JulianSamblas/realtime-telemetry-esp32s3/docs/TFG_presentacion_Julian_Samblas.pdf

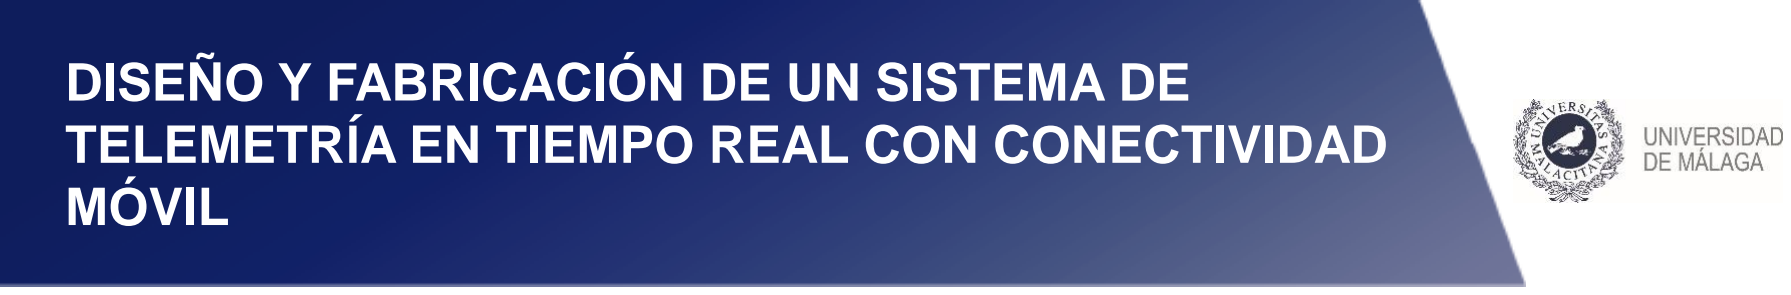
[picture p27: figure]
DISEÑO Y FABRICACIÓN DE UN SISTEMA DE; MÓVIL

### TELEMETRÍA EN TIEMPO REAL CON CONECTIVIDAD

Autor:
JULIÁN SAMBLÁS CABALLERO
Tutor:
JAVIER PÉREZ FERNÁNDEZ

GRADO EN INGENIERÍA ELECTRÓNICA INDUSTRIAL Trabajo Fin de Grado
Junio 2024

# ÍNDICE

DISEÑO Y FABRICACIÓN DE UN SISTEMA DE TELEMETRÍA EN TIEMPO REAL CON CONECTIVIDAD MÓVIL

## 1 Introducción

## 2 Telemetría y adquisición de datos

## 3 Componentes del dispositivo

## 5 Métodos de adquisición y visualización de datos

## 6 Montaje y pruebas realizadas al dispositivo en funcionamiento

## 7 Conclusiones y futuro del proyecto

## 4 Prototipos

# 1. INTRODUCCIÓN 1

4

2

5

3

6

Antecedentes:

- Pertenece al programa de maduración de proyectos UMA
- Tecnología del automovilismo de competición al usuario
amateur

Programa Synride

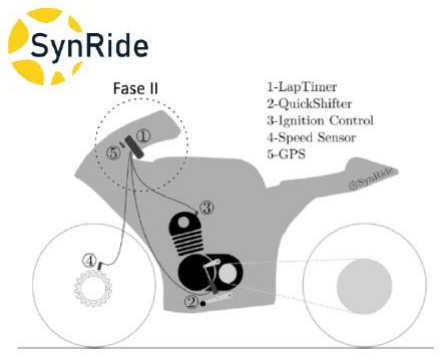
[picture p28: figure]

- Tiempo por vuelta
- QuickShifter
- Control de encendido
- Sensor de velocidad
- GPS

Modelo anterior

7

# 1. INTRODUCCIÓN 1

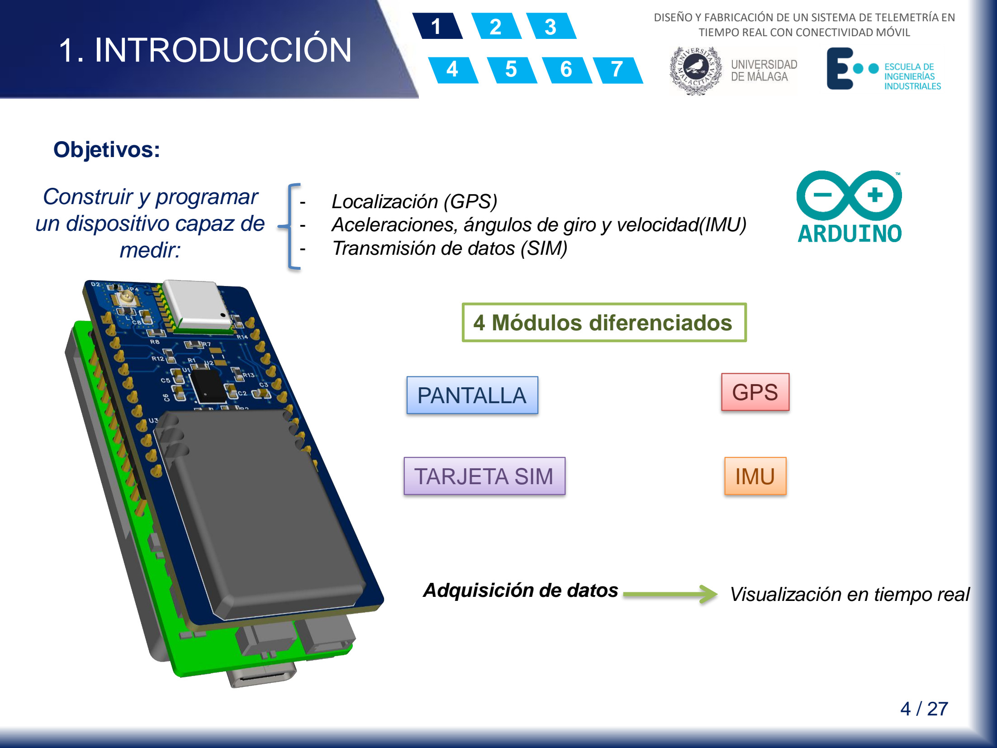
[picture p29: page 4]

4

5

6

Objetivos:

- Localización (GPS)
- Aceleraciones, ángulos de giro y velocidad(IMU)
- Transmisión de datos (SIM)

### 4 Módulos diferenciados

Adquisición de datos

Construir y programar
un dispositivo capaz de
medir:
PANTALLA | GPS
TARJETA SIM | IMU

Visualización en tiempo real

7

## 2. TELEMETRÍA Y ADQUISICIÓN DE DATOS

1

4

5

6

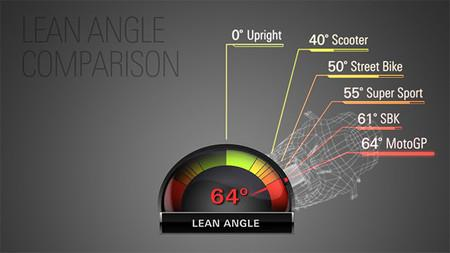
[picture p30: figure]

1) ¿Qué es la telemetría y adquisición de

datos?

2) Estado del arte
3) Importancia de la adquisición de datos en la

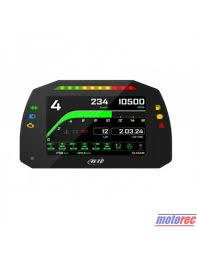
[picture p31: figure]

actualidad

4) Importancia de la adquisición de datos en el

mundo del motor

5) Telemetría aplicada a la competición
6) Objetivos del sistema proyectado

7

## 3. COMPONENTES DEL DISPOSITIVO

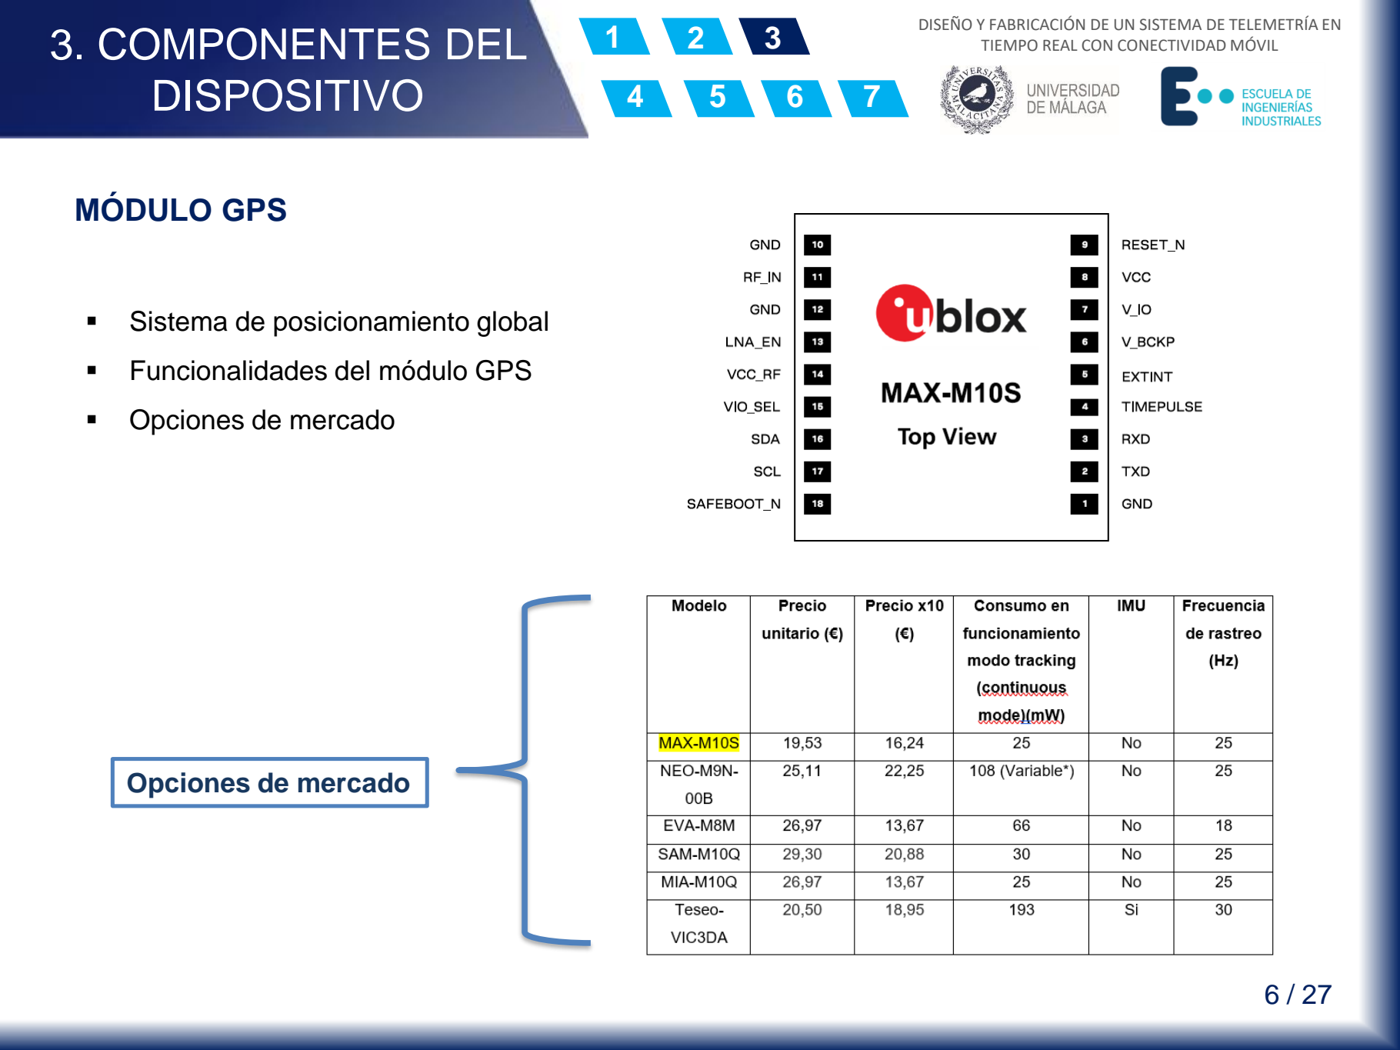
[picture p32: page 6]

4

5

6

- Sistema de posicionamiento global
- Funcionalidades del módulo GPS
- Opciones de mercado

MÓDULO GPS

Opciones de mercado

7

## 3. COMPONENTES DEL DISPOSITIVO

4

5

6

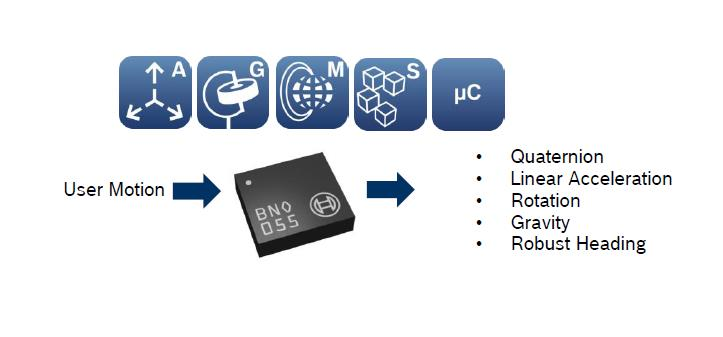
[picture p33: figure]

- Desempeña un papel crucial
- Medición de aceleración y velocidad angular
- Análisis de inclinación
- Sistemas de estabilización electrónica

UNIDAD DE MEDIDA INERCIAL (IMU)

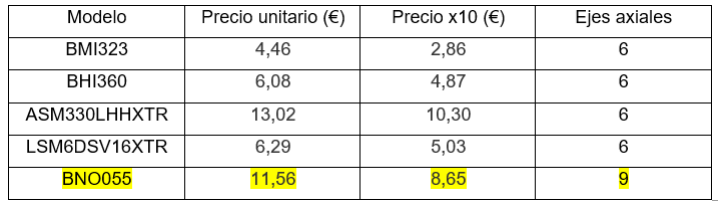
[picture p34: figure]

Opciones de mercado

7

## 3. COMPONENTES DEL DISPOSITIVO

4

5

6

- Enviar la información obtenida a través de internet
- Ocupación de espacio mínimo en la placa PBC
- Capacidad de operar en una banda 4G

MÓDULO SIM

Opciones de mercado

7

## 3. COMPONENTES DEL DISPOSITIVO

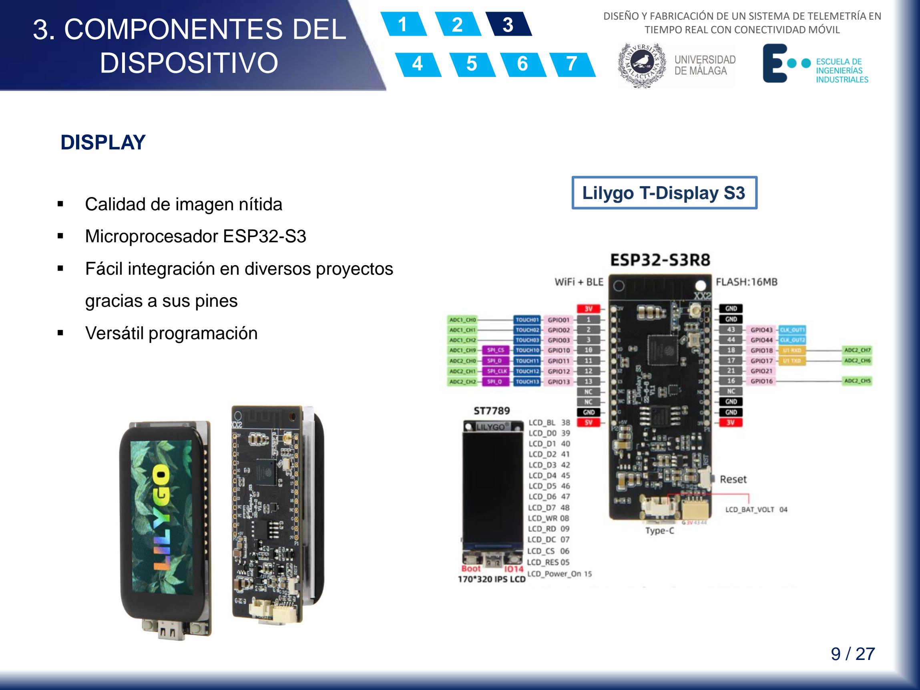
[picture p35: page 9]

4

5

6

- Calidad de imagen nítida
- Microprocesador ESP32-S3
- Fácil integración en diversos proyectos

gracias a sus pines

- Versátil programación

DISPLAY

Lilygo T-Display S3

7

## 4. PROTOTIPOS

4

5

6

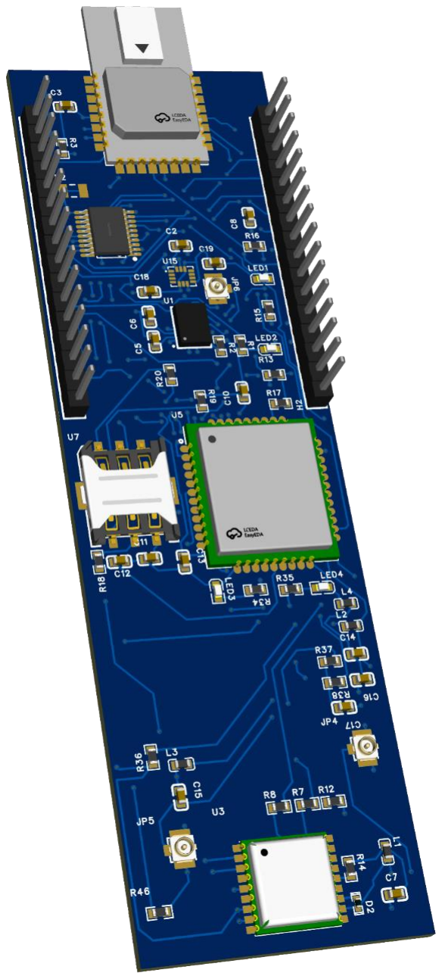
[picture p36: figure]

PRIMER PROTOTIPO

Basado en la placa T-SIM7080G-S3

- Potente procesador
- Incorporación del módulo SIM

Módulos acoplados

- Dos sistemas de posicionamiento: MAX-M10S y DWM3000
- Dos sistemas inerciales de medida: BNO055 y BMI323.

7

## 4. PROTOTIPOS

4

5

6

PRIMER PROTOTIPO

7

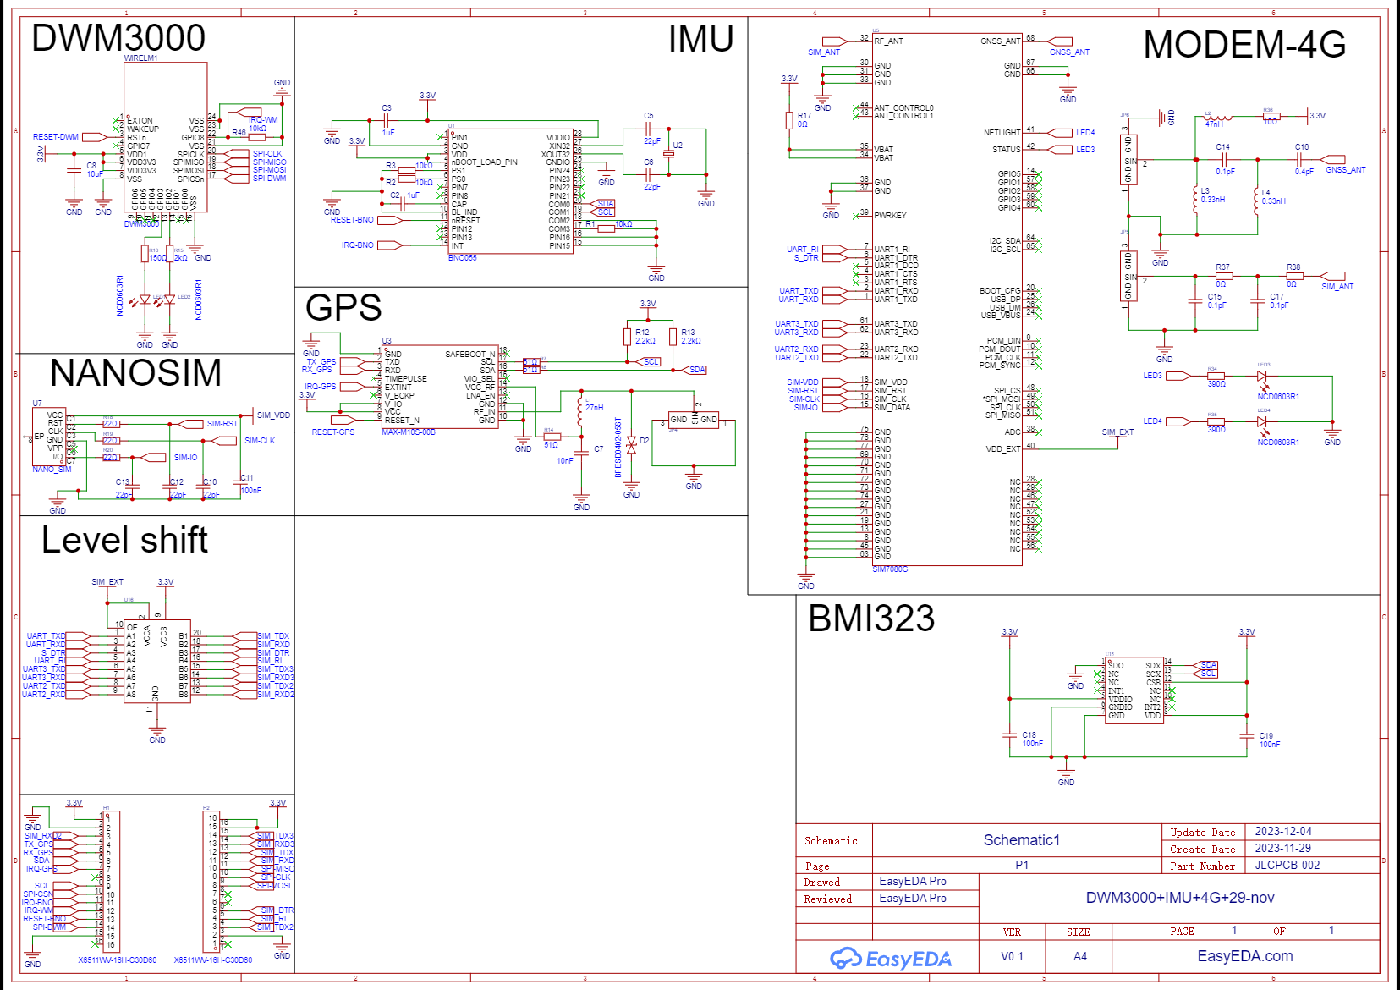
[picture p37: figure]

## 4. PROTOTIPOS

4

5

6

SEGUNDO PROTOTIPO

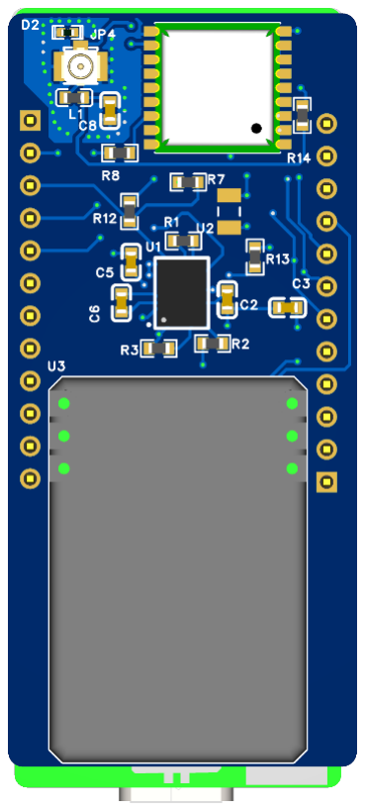
[picture p38: figure]
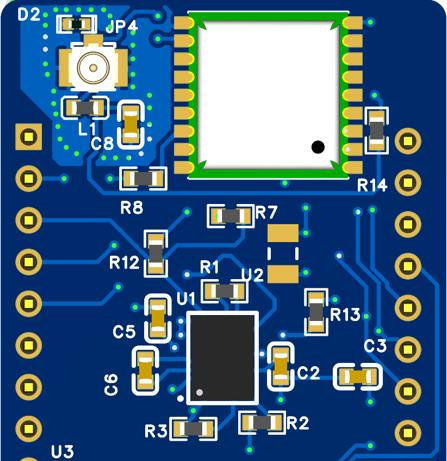
[picture p39: figure]

Basado en el dispositivo T-DISPLAY-S3

- Potente procesador
- Menor tamaño
- Acople de display

Módulos acoplados

- Sistema de posicionamiento:

MAX-M10S

- Sistema inercial de medida:

BNO055

- Módulo SIM: SIM7080

7

## 4. PROTOTIPOS

4

5

6

SEGUNDO PROTOTIPO

Basado en el dispositivo T-DISPLAY-S3

7

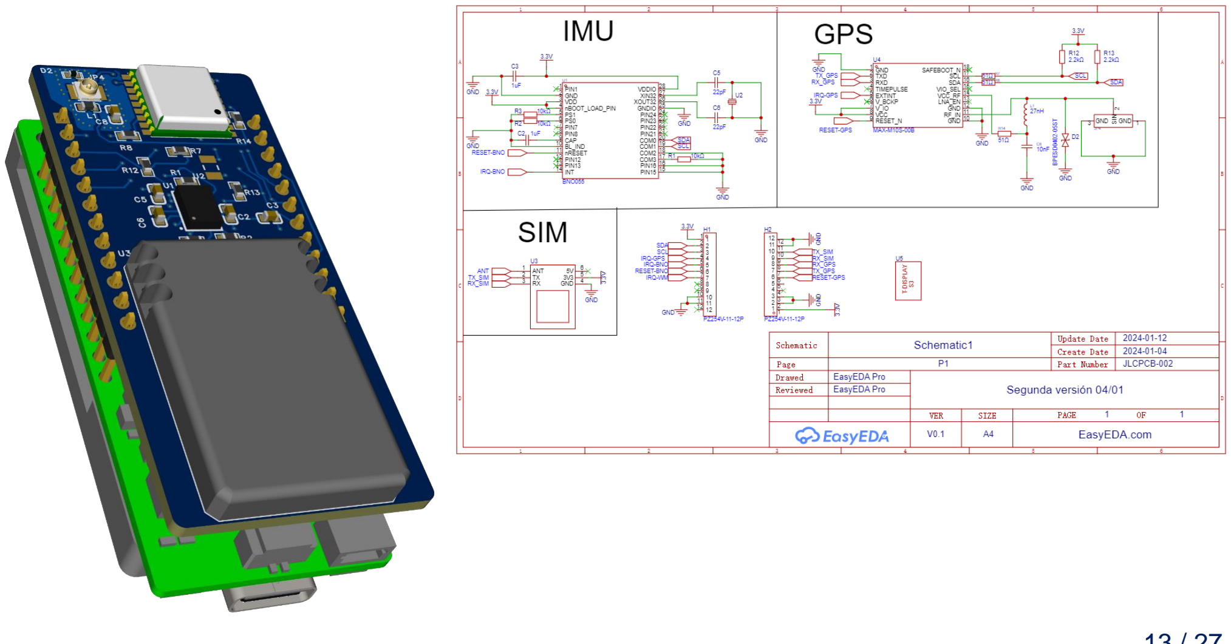
[picture p40: figure]

## 5. MÉTODO DE ADQUISICIÓN Y VISUALIZACIÓN DE DATOS

4

5

6

PROTOCOLOS DE COMUNICACIÓN UTILIZADOS

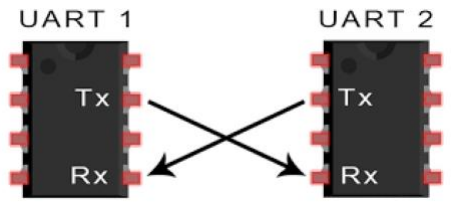
[picture p41: figure]

GPS

SIM

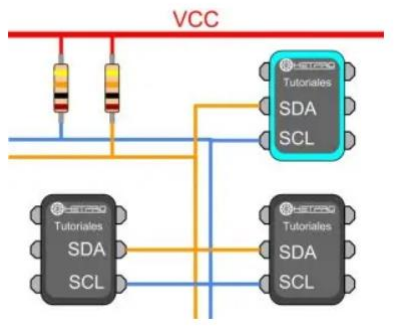
[picture p42: figure]

IMU

7

## 5. MÉTODO DE ADQUISICIÓN Y VISUALIZACIÓN DE DATOS

4

5

6

PROGRAMACIÓN EN SQUARE LINE STUDIO Y ARDUINO IDE

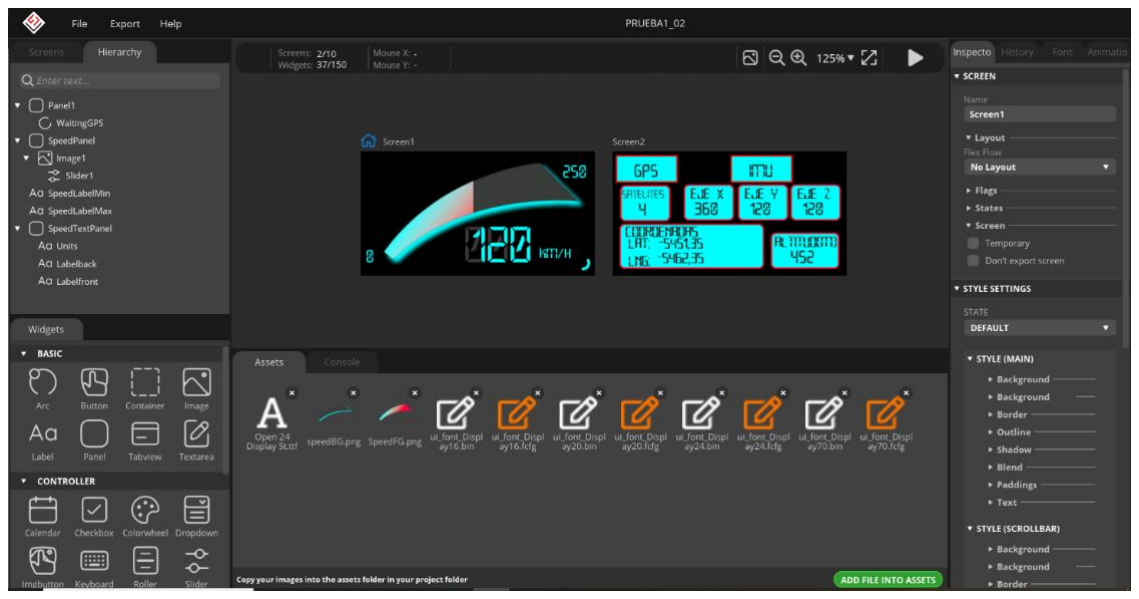
[picture p43: figure]

SQUARE LINE STUDIO

Configurador de diseños

- Programación más intuitiva y rápida

que de manera convencional

- Facilidad de adaptación a Arduino IDE

gracias a la librería LVGL

7

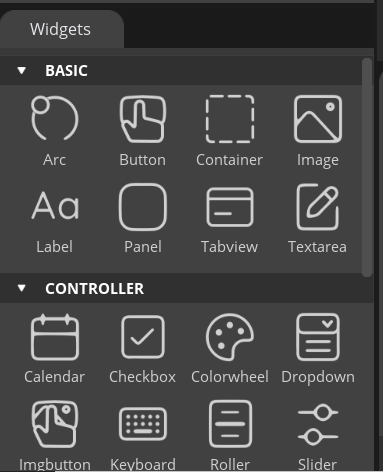
[picture p44: figure]
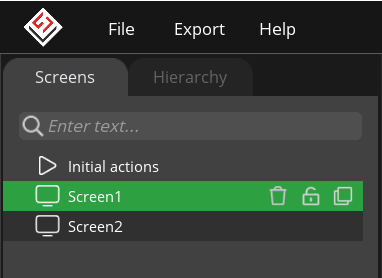
[picture p45: figure]

## 5. MÉTODO DE ADQUISICIÓN Y VISUALIZACIÓN DE DATOS

4

5

6

PROGRAMACIÓN EN SQUARE LINE STUDIO Y ARDUINO IDE

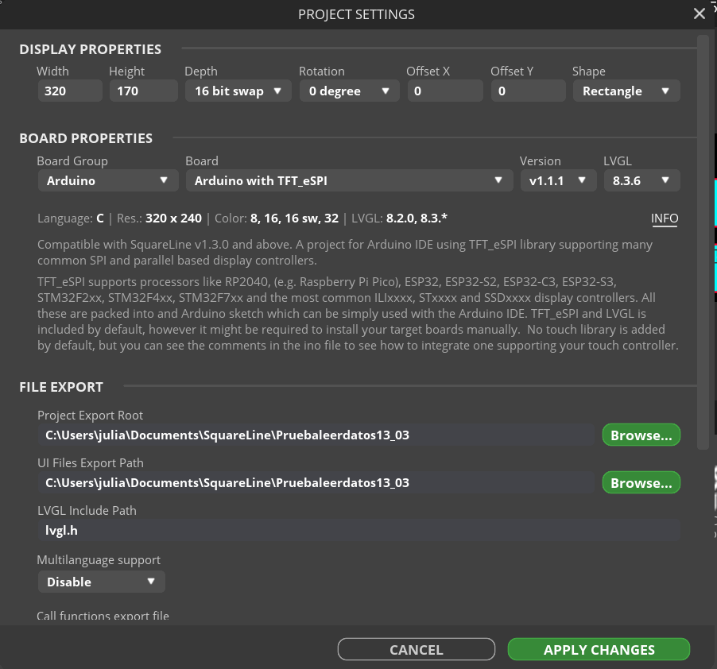
[picture p46: figure]

SQUARE LINE STUDIO

- Configuración de exportación de

archivos

- Profundidad de colores de la pantalla
- Ancho y largo de pantalla
- Versión de la librería

7

## 5. MÉTODO DE ADQUISICIÓN Y VISUALIZACIÓN DE DATOS

4

5

6

PROGRAMACIÓN EN SQUARE LINE STUDIO Y ARDUINO IDE

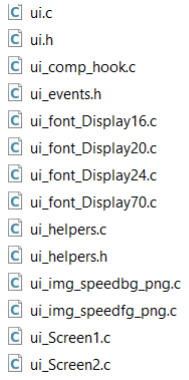
[picture p47: figure]

- Adaptación de los archivos

exportados desde Square Line

Studio

- Añadir el archivo pin.h extraído

de Lilygo para la configuración

de los pines del Display

- Estructura del código principal:
inclusión | de | librerías,
declaración | de | variables,

funciones auxiliares, función

setup(), función loop().

7

## 5. MÉTODO DE ADQUISICIÓN Y VISUALIZACIÓN DE DATOS

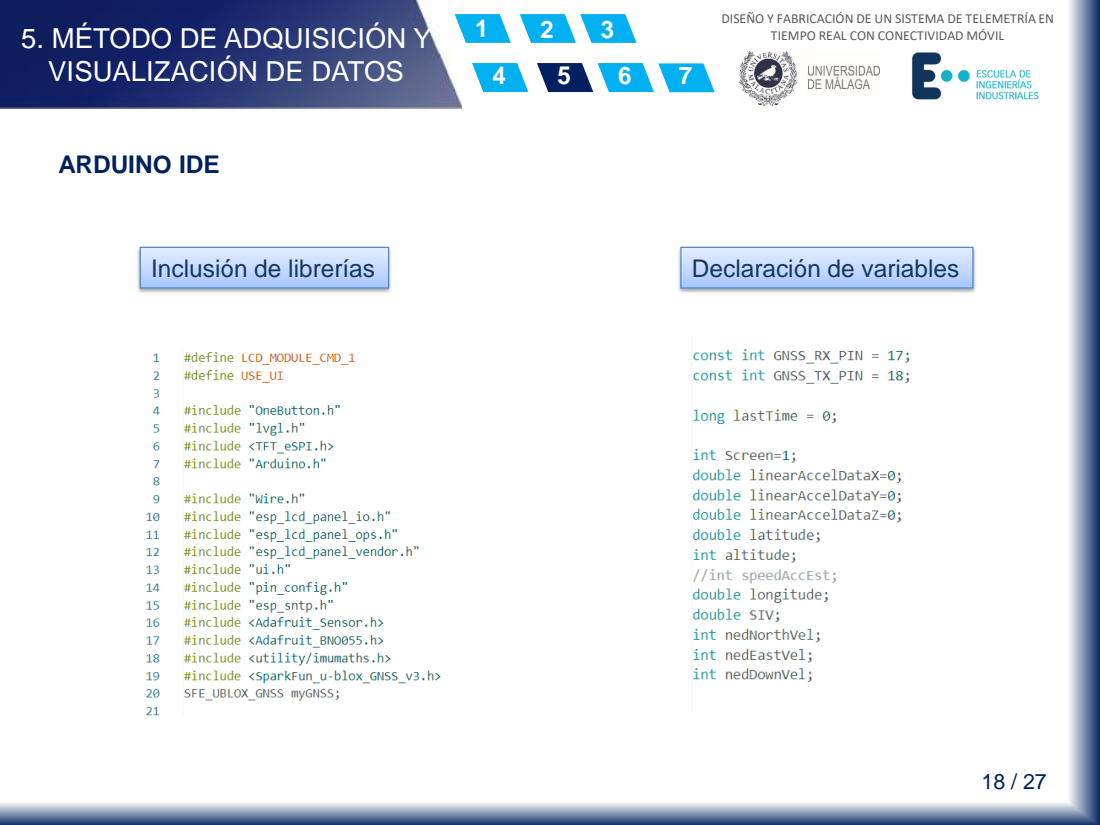
[picture p48: page 18]
ARDUINO IDE

Inclusión de librerías

Declaración de variables

## 5. MÉTODO DE ADQUISICIÓN Y VISUALIZACIÓN DE DATOS

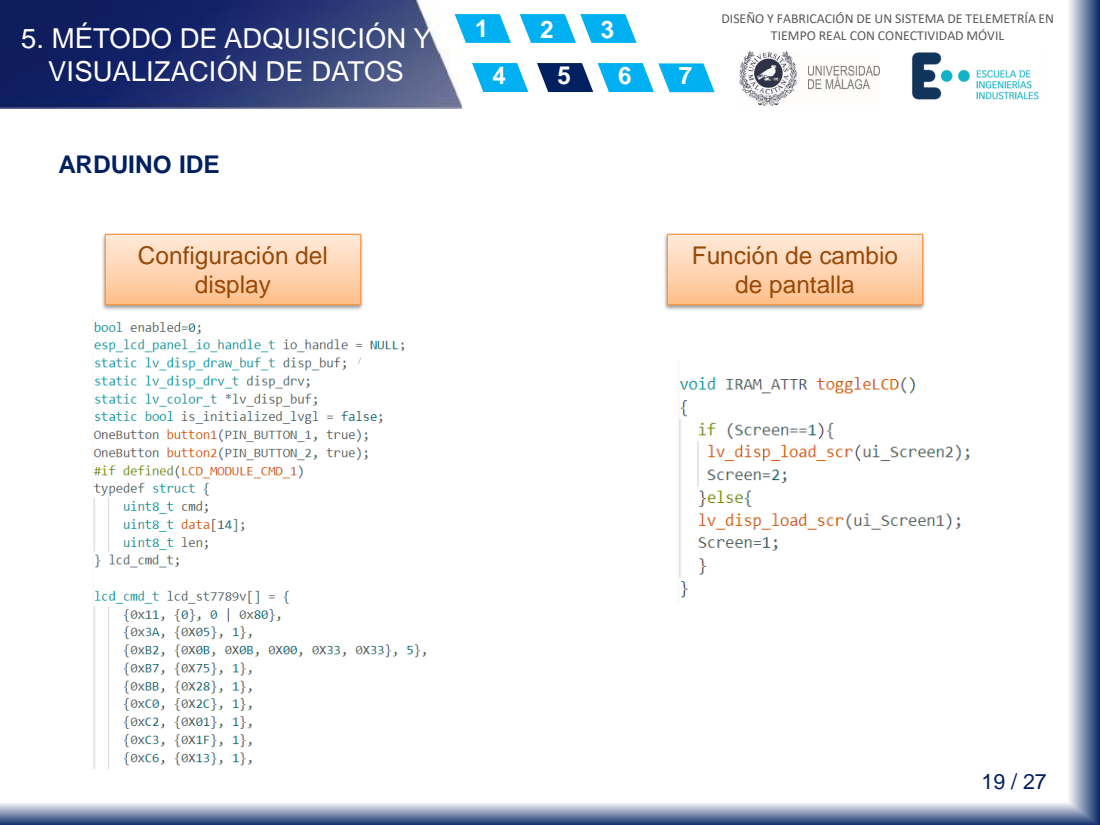
[picture p49: page 19]
ARDUINO IDE; Configuración del display

Función de cambio
de pantalla

## 5. MÉTODO DE ADQUISICIÓN Y VISUALIZACIÓN DE DATOS

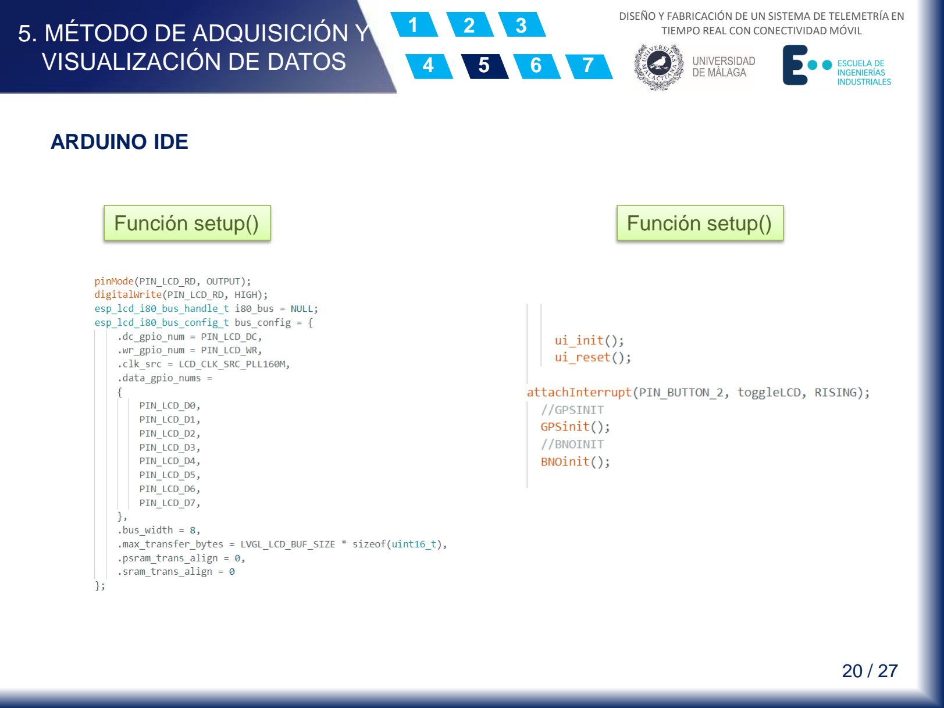
[picture p50: page 20]

4

5

6

ARDUINO IDE

Función setup()

7

Función setup()

## 5. MÉTODO DE ADQUISICIÓN Y VISUALIZACIÓN DE DATOS

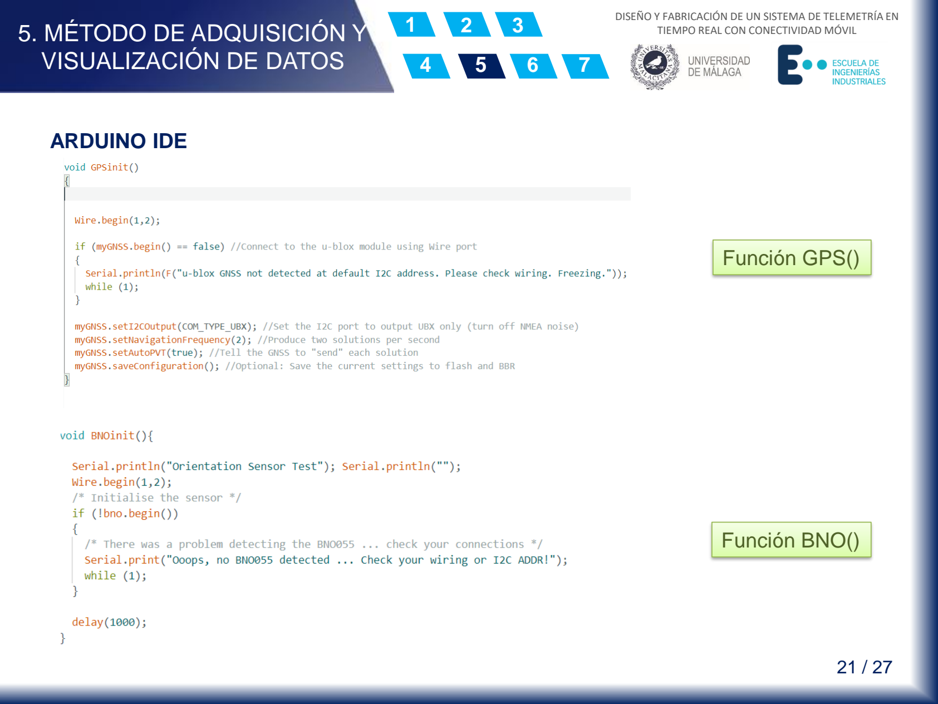
[picture p51: page 21]

4

5

6

ARDUINO IDE

Función GPS()

7

Función BNO()

## 5. MÉTODO DE ADQUISICIÓN Y VISUALIZACIÓN DE DATOS

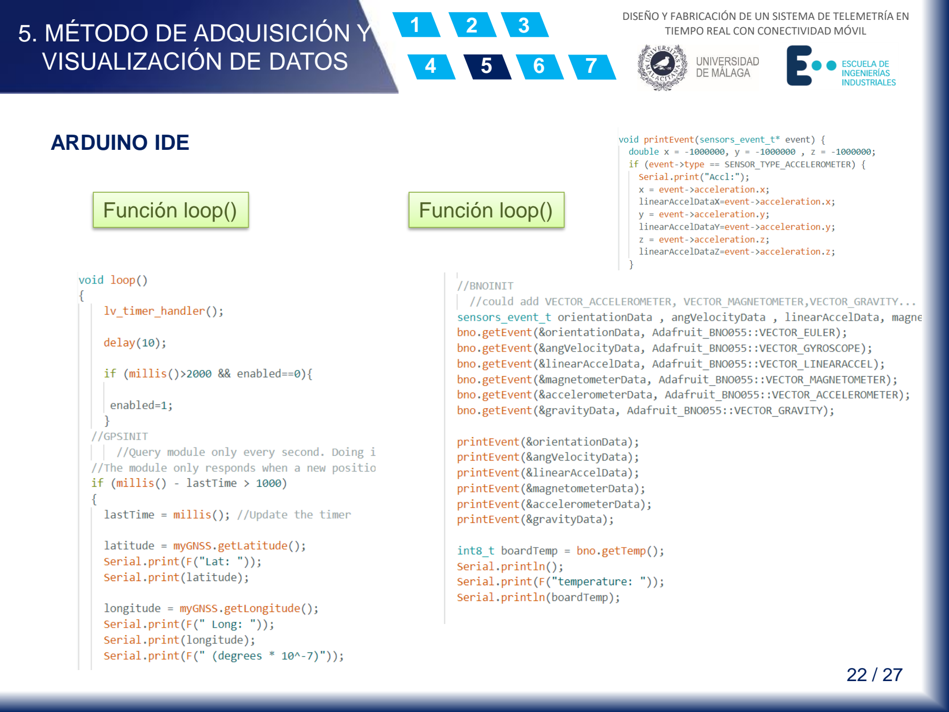
[picture p52: page 22]

4

5

6

ARDUINO IDE

Función loop()

7

Función loop()

## 5. MÉTODO DE ADQUISICIÓN Y VISUALIZACIÓN DE DATOS

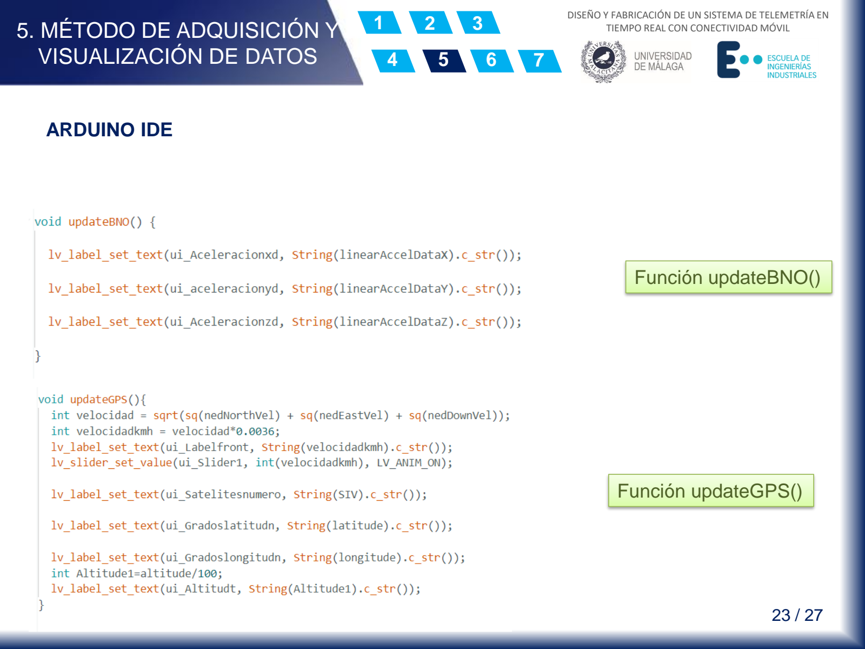
[picture p53: page 23]

4

5

6

ARDUINO IDE

Función updateGPS()

7

Función updateBNO()

# 6. MONTAJE Y PRUEBAS

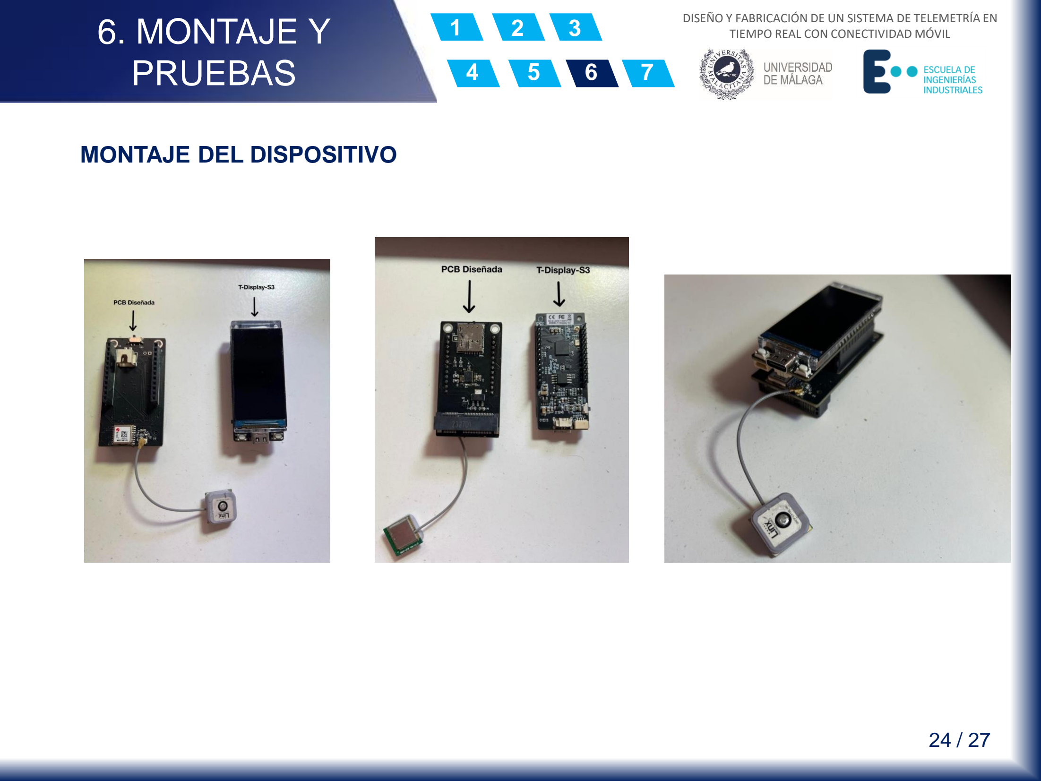
[picture p54: page 24]

4

5

6

MONTAJE DEL DISPOSITIVO

7

# 6. MONTAJE Y PRUEBAS

4

5

6

MONTAJE DEL DISPOSITIVO

7

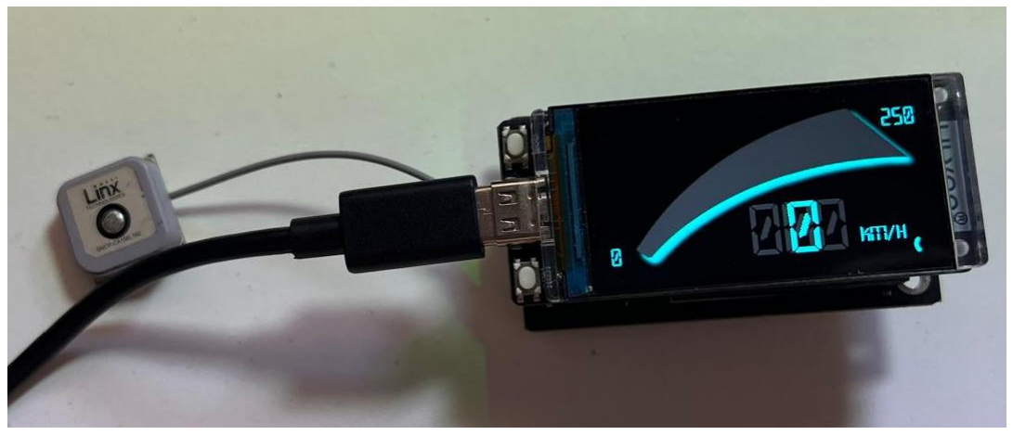
[picture p55: figure]
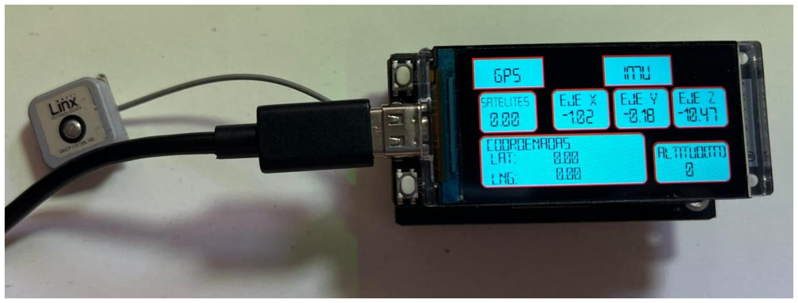
[picture p56: figure]

# 6. MONTAJE Y PRUEBAS

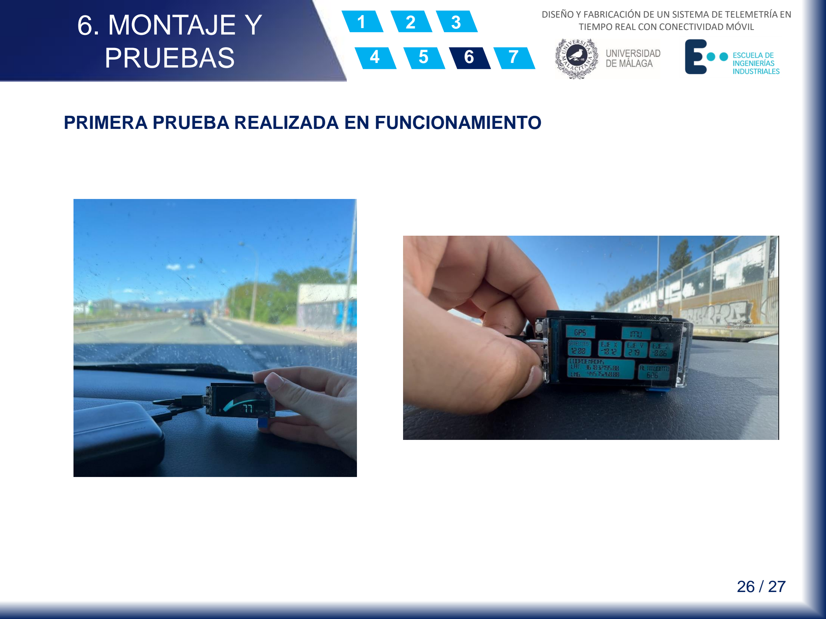
[picture p57: page 26]

4

5

6

PRIMERA PRUEBA REALIZADA EN FUNCIONAMIENTO

7

# 6. MONTAJE Y PRUEBAS

4

5

6

PRUEBA DE TRAYECTORIA

7

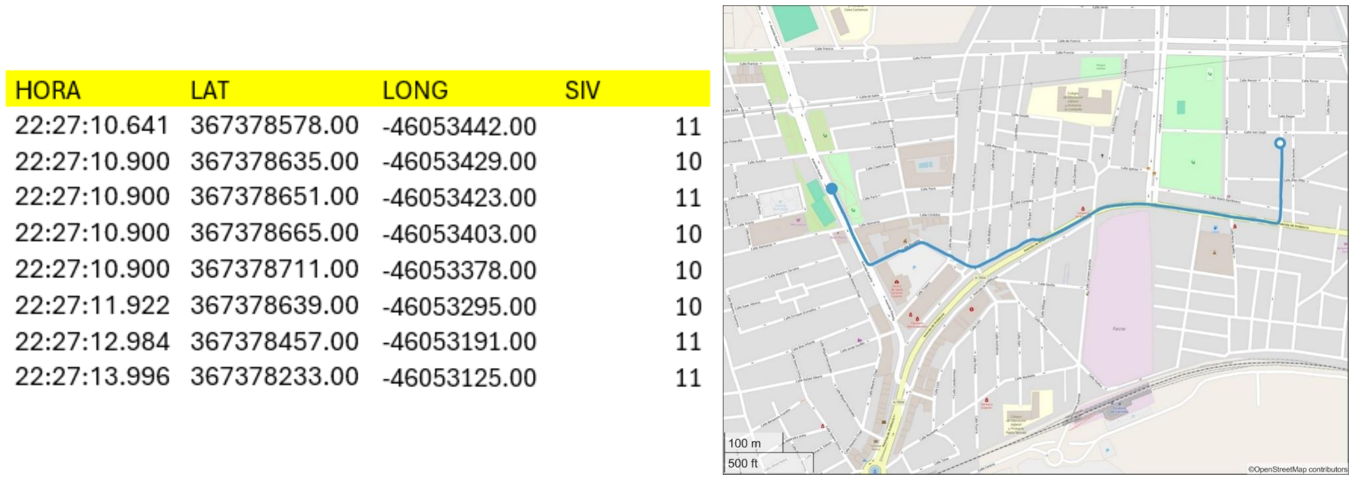
[picture p58: figure]

# 7. CONCLUSIÓN Y FUTURO

4

5

6

- Muestra de datos obtenidos en tiempo real con

gran exactitud

- Mejora del dispositivo gracias al segundo

prototipo del proyecto

- Impedimentos por falta de información acerca

de la pantalla T-Display-S3

- Square Line Studio y LVGL
- Futura visualización de los valores obtenidos
- Futuro del proyecto:
- Enviar los datos obtenidos en tiempo real a una

página web llamada SpeedSense

- Visualizar estos valores en su contexto
- Mejorar las habilidades de conducción del

piloto

### DISEÑO Y FABRICACIÓN DE UN SISTEMA DE TELEMETRÍA EN TIEMPO REAL CON CONECTIVIDAD MÓVIL

Conclusión

7

### TELEMETRÍA EN TIEMPO REAL CON CONECTIVIDAD

Autor:
JULIÁN SAMBLÁS CABALLERO
Tutor:
JAVIER PÉREZ FERNÁNDEZ

GRADO EN INGENIERÍA ELECTRÓNICA INDUSTRIAL Trabajo Fin de Grado
Junio 2024
