JulianSamblas/realtime-telemetry-esp32s3/images/pcb-v1-3d.jpg

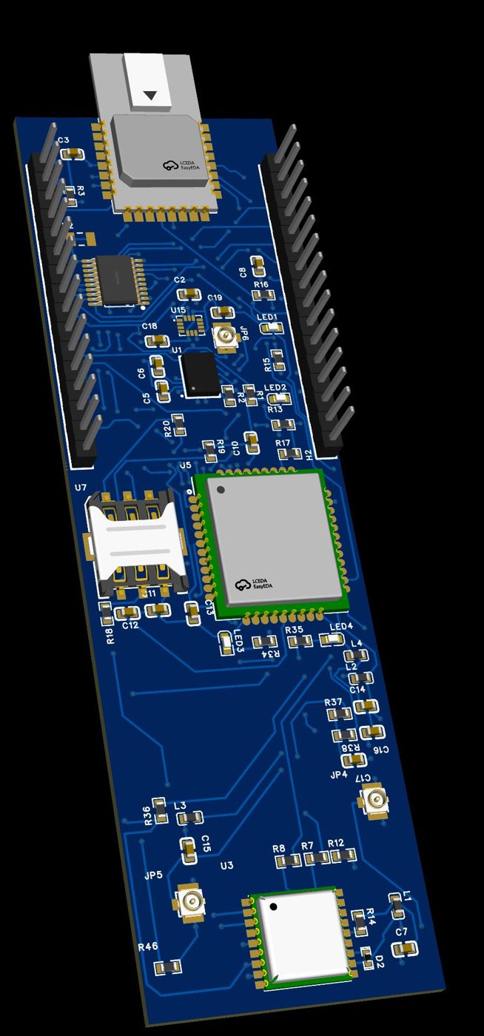
images/pcb-v1-3d.jpg
